RobertGawron/GeigerMullerCounter/Software/HardwareDataLogger/README.md

# HardwareDataLogger

 

## Summary

It's a simple hardware data logger, that presents data both on LCD and via COM port so it's possible to gather data using PC and do further analysis. Currently it supports only pulse counting.

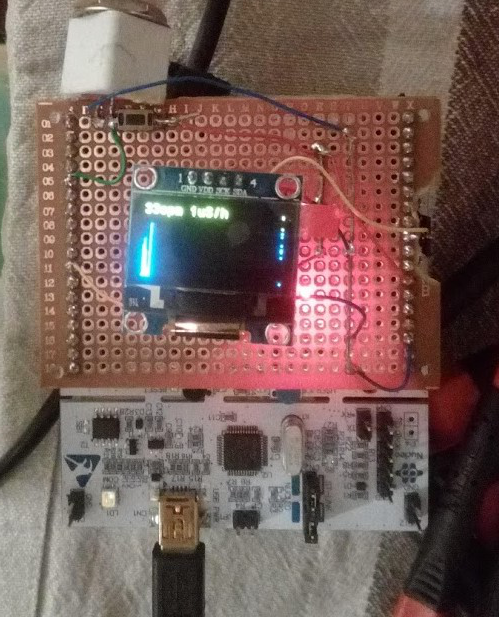
[picture p3: Software/HardwareDataLogger/Documentation/Pictures/Device_10_01_2019.jpg]
Device Picture


## Hardware

The device is based on NUCLEO-F091RC evaluation board with added custom-made shield.

TODO: hardware documentation of the shield.

## Software

Firmware were made using CubeMX, Eclipse is used for firmware development.

PC Simulation of Firmware was made using Python+Qt, it uses build .so variant of the firmware (Makefile is used for firmware variant generation).
