RobertGawron/GeigerMullerCounter/Hardware/GeigerMullerCounter/GeigerMullerCounter.kicad_pcb

## KiCad design Hardware/GeigerMullerCounter/GeigerMullerCounter.kicad_pcb (2024-09-13)

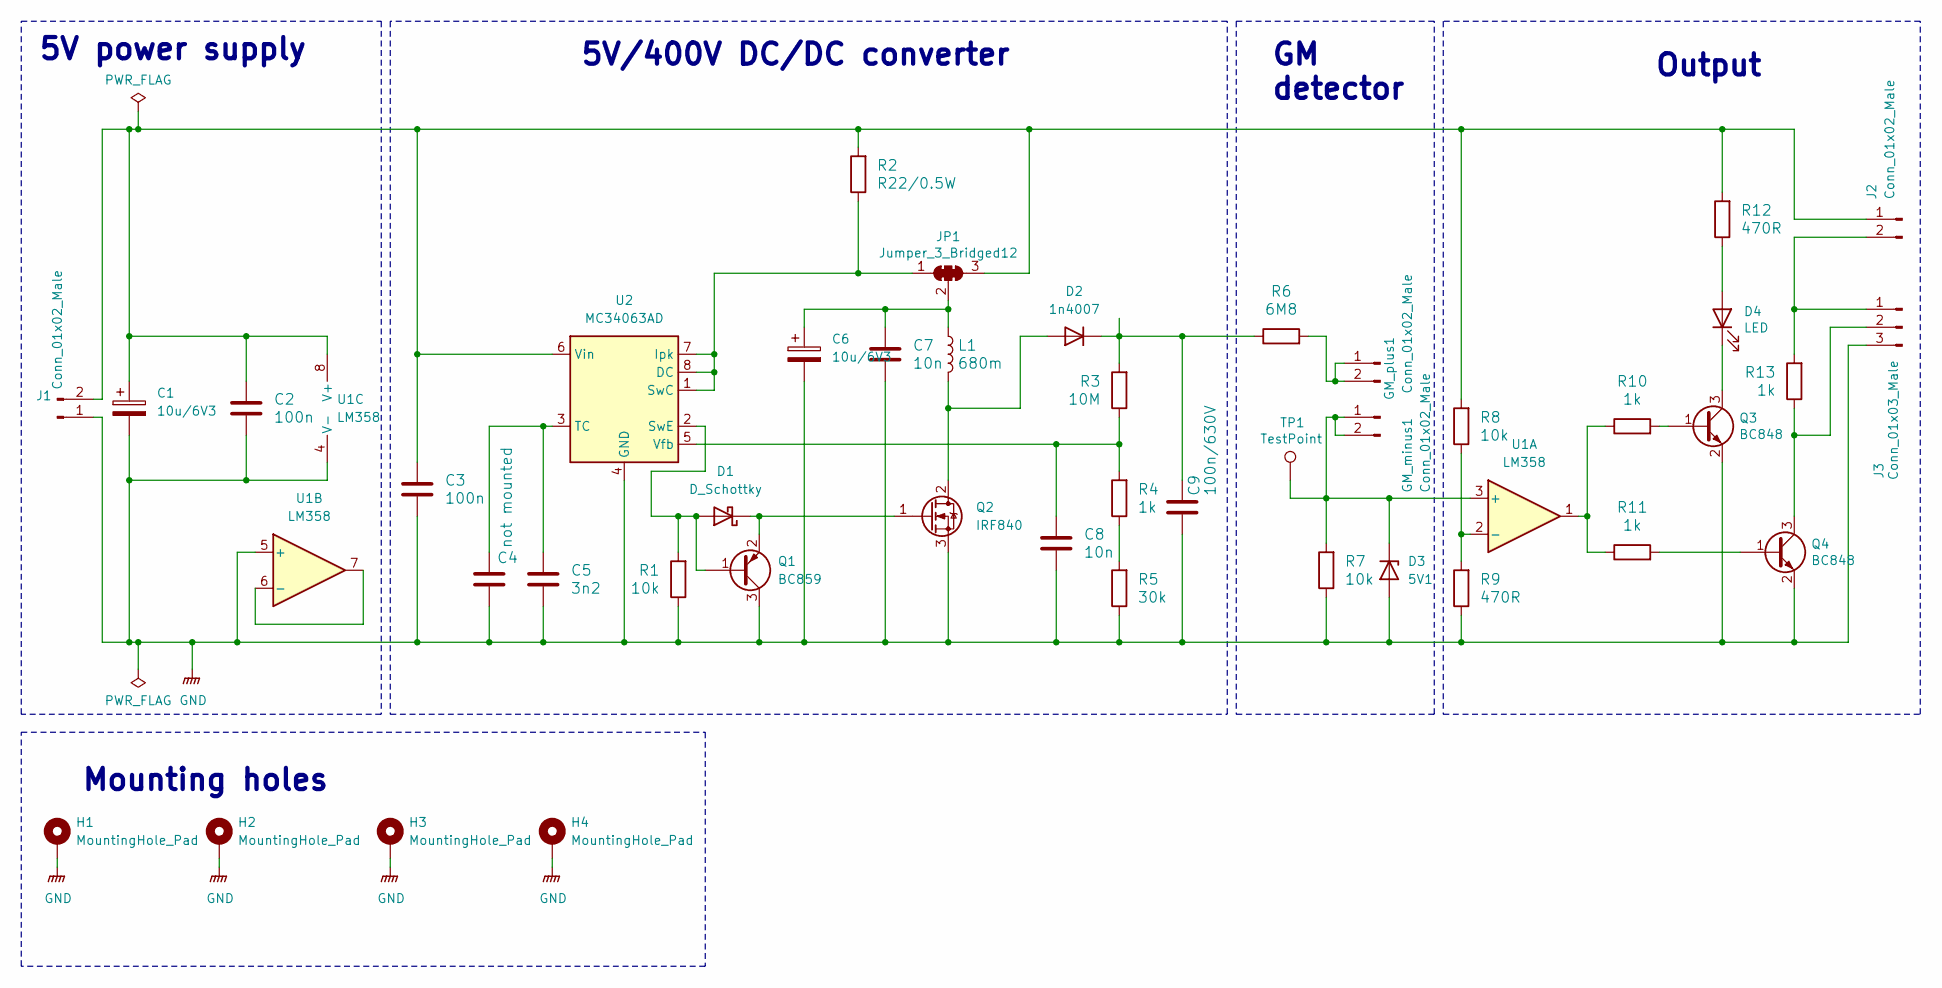
[picture p5: schematic GeigerMullerCounter.kicad_sch]

Parts:
C1, C6: 10u/6V3; CP_EIA-3528-21_Kemet-B
C2, C3: 100n; C_0805_2012Metric
C4: not mounted; C_0805_2012Metric
C5: 3n2; C_0805_2012Metric
C7, C8: 10n; C_0805_2012Metric
C9: 100n/630V; C_Rect_L13.5mm_W5.0mm_P10.00mm_FKS3_FKP3_MKS4
D1: D_Schottky; D_SOT-23_ANK
D2: 1n4007; D_DO-41_SOD81_P7.62mm_Horizontal
D3: 5V1; D_A-405_P2.54mm_Vertical_KathodeUp
D4: LED; LED_0805_2012Metric
GM_minus1: Conn_01x02_Male; Pin_Header_Straight_1x02_Pitch2.54mm
GM_plus1: Conn_01x02_Male; Pin_Header_Straight_1x02_Pitch2.54mm
H1, H2, H3, H4: MountingHole_Pad; MountingHole_3.5mm_Pad
J1, J2: Conn_01x02_Male; PinHeader_1x02_P2.54mm_Vertical
J3: Conn_01x03_Male; PinHeader_1x03_P2.54mm_Vertical
JP1: Jumper_3_Bridged12; SolderJumper-3_P1.3mm_Bridged12_Pad1.0x1.5mm
L1: 680m; L_Radial_D7.5mm_P5.00mm_Fastron_07P
Q1: BC859; TSOT-23
Q2: IRF840; TO-220-3_Vertical
Q3, Q4: BC848; SOT-23
R1, R8: 10k; R_0805_2012Metric
R2: R22/0.5W; R_Axial_DIN0207_L6.3mm_D2.5mm_P2.54mm_Vertical
R3: 10M; R_Axial_DIN0207_L6.3mm_D2.5mm_P5.08mm_Vertical
R4, R10, R11, R13: 1k; R_0805_2012Metric
R5: 30k; R_0805_2012Metric
R6: 6M8; R_Axial_DIN0207_L6.3mm_D2.5mm_P7.62mm_Horizontal
R7: 10k; R_0805_2012Metric_Pad1.15x1.40mm_HandSolder
R9, R12: 470R; R_0805_2012Metric
TP1: TestPoint; TestPoint_Pad_D1.5mm
U1: LM358; SO-8_5.3x6.2mm_P1.27mm
U2: MC34063AD; SO-8_5.3x6.2mm_P1.27mm

Connections:
GND: C1.2, C2.2, C3.2, C4.2, C5.2, C6.2, C7.2, C8.2, C9.2, D3.2 (A), H1.1, H2.1, H3.1, H4.1, J1.1, J3.3, Q1.3 (C), Q2.3 (S), Q3.2 (E), Q4.2 (E), R1.1, R5.1, R7.1, R9.1, U1.4 (V-), U1.5 (+), U2.4 (GND)
unnamed: D1.2 (A), Q1.1 (B), R1.2, U2.2 (SwE)
unnamed: D1.1 (K), Q1.2 (E), Q2.1 (G)
unnamed: D2.2 (A), L1.2, Q2.2 (D)
unnamed: C9.1, D2.1 (K), R3.2, R6.1
unnamed: D3.1 (K), GM_minus1.1, GM_minus1.2, R7.2, TP1.1, U1.3 (+)
unnamed: D4.2 (A), R12.1
unnamed: D4.1 (K), Q3.3 (C)
unnamed: GM_plus1.1, GM_plus1.2, R6.2
unnamed: C1.1, C2.1, C3.1, J1.2, J2.1, JP1.3 (B), R2.2, R8.2, R12.2, U1.8 (V+), U2.6 (Vin)
unnamed: J2.2, J3.1, R13.2
unnamed: J3.2, Q4.3 (C), R13.1
unnamed: JP1.1 (A), R2.1, U2.1 (SwC), U2.7 (Ipk), U2.8 (DC)
unnamed: C6.1, C7.1, JP1.2 (C), L1.1
unnamed: Q3.1 (B), R10.2
unnamed: Q4.1 (B), R11.2
unnamed: R4.1, R5.2
unnamed: R10.1, R11.1, U1.1
unnamed: R8.1, R9.2, U1.2 (-)
unnamed: U1.6 (-), U1.7
unnamed: C4.1, C5.1, U2.3 (TC)
unnamed: C8.1, R3.1, R4.2, U2.5 (Vfb)

Notes on the sheet:
Mounting holes
Output
5V/400V DC/DC converter
GM detector
5V power supply

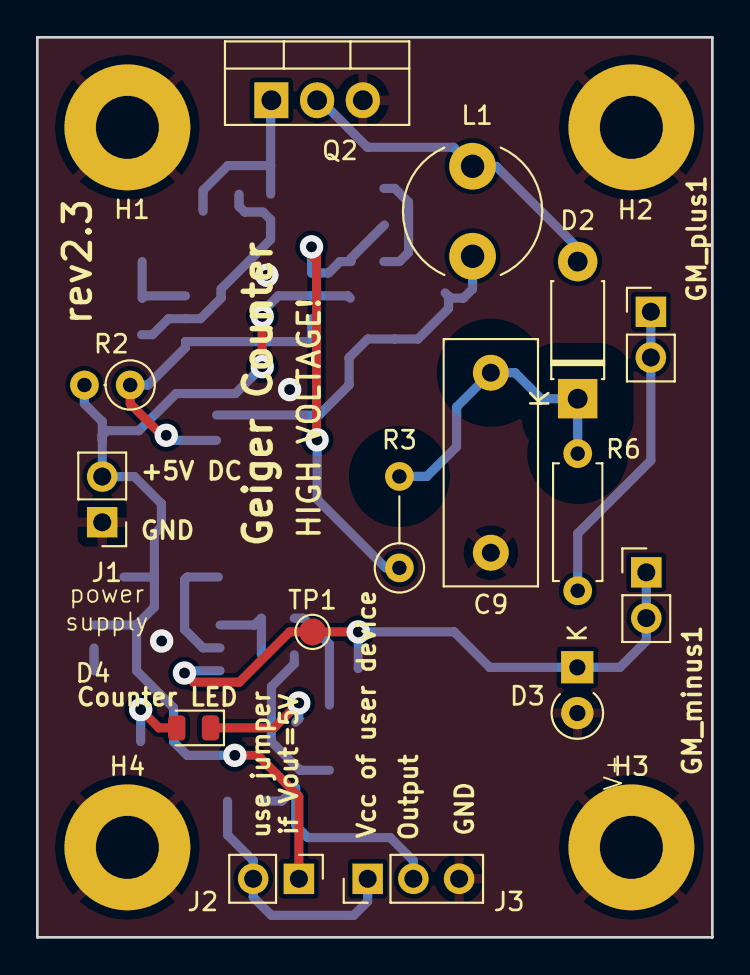
[picture p6: board GeigerMullerCounter.kicad_pcb from above]

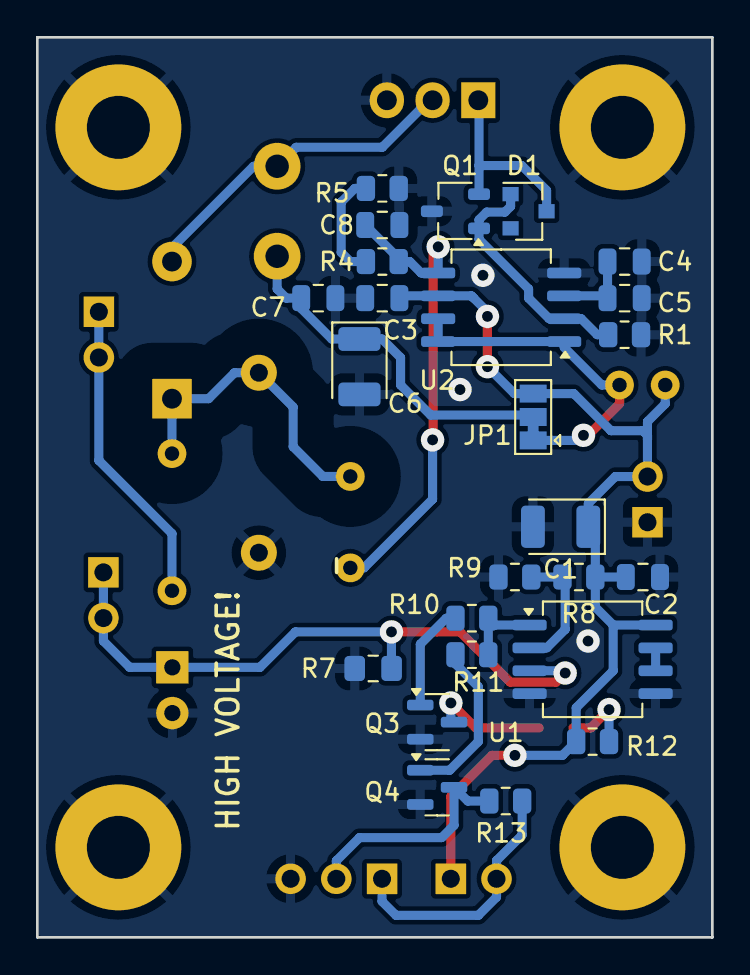
[picture p7: board GeigerMullerCounter.kicad_pcb from below]

Board: 2 copper layers, 37.5 x 50.0 mm, 44 parts (25 on the bottom side), 22 nets.
