RobertGawron/GeigerMullerCounter/(threads)

Thread 2 (2015-07-02):

Store data permanently.

RobertGawron, 2015-07-02:
Store data on the SD card or in EEPROM, provide way to download the data to the PC.

RobertGawron, 2019-08-11:
STM32 board and its firmware will be replaced by dedicated data acquisition module.

Closed 2019-08-11.

Thread 5 (2015-07-02):

Verify transistor type for driving the speaker.

RobertGawron, 2015-07-02:
What should be the max power of the transistor?

RobertGawron, 2018-09-15:
speaker no longer in use (but still is as an option on the pcb)

Closed 2018-09-15.

Thread 6 (2015-07-02):

HW filtering capacitor has incorrect package.

RobertGawron, 2015-07-02:
Fix according to capacitor type/package used.

Closed 2018-09-15.

Thread 7 (2015-07-02):

Add Bluetooth support.

RobertGawron, 2015-07-02:
Based on HC-05 board.

RobertGawron, 2019-08-11:
STM32 board and its firmware will be replaced by dedicated data acquisition module.

Closed 2019-08-11.

Thread 9 (2015-07-02):

Add unit tests.

RobertGawron, 2015-07-02:
Framework: Check
http://check.sourceforge.net/

RobertGawron, 2018-09-15:
Would be especially (or maybe only) useful for CircularBuffer.

RobertGawron, 2019-08-11:
STM32 board and its firmware will be replaced by dedicated data acquisition module.

Closed 2019-08-11.

Thread 10 (2015-07-03):

SD Card support

RobertGawron, 2015-07-03:
Lib: http://stm32f4-discovery.com/2014/07/library-21-read-sd-card-fatfs-stm32f4xx-devices/

RobertGawron, 2018-09-15:
Duplicates with #2

Closed 2018-09-15.

Thread 12 (2016-08-22):

Question

MatejKovacic, 2016-08-22:
Hi,

sorry to bother you here. I was looking for your contact on your website, but there is none.

Anyway, I found your project very interesting. In fact, I have one SBM-20 Geiger tube (I planned to build my own Geiger counter a few years ago, but never finished it). What is the difference between this and your STS-5 tube?

Also, where did you find metallic holders for lamps? Do you have a figure (picture of a prototype) of the circuit and list of required materials?

And the final question - did you plan to make a digital Geiger counter based on Raspberry Pi?

P. S. My e-mail can be found here: https://keyserver.ubuntu.com/pks/lookup?op=get&search=0xBEA5286DA9CF4A88

Regards,
M.

RobertGawron, 2017-01-06:
One can be replaced by other, they are pretty much the same.

Holders are just regular fuses holders, Russians were smart and mechanically designed theirs tubes to be able to place them in holders popular in civil equipment - stocks of popular parts are easier to find in case of e.g. war.

Circuit is presented here: https://robertgawron.blogspot.com/2015/02/homemade-geigermuller-counter-part-i.html

I don't plan at the moment, but there is version for Aurduino:
https://robertgawron.blogspot.com/2016/07/using-arduino-to-process-data-from_24.html

TBH its histograms works quite awful, but rest of it is ok.

Regards,
Bob

Closed 2018-09-15.

Thread 56 (2019-09-30):

geiger with stm32

123LY321, 2019-09-30:
Sorry to bother you, but I want to make a geiger detection suite for the main chip using stm32. Can I get a circuit diagram from you? Thank you

RobertGawron, 2019-09-30:
Hi,

you need a diagram of the gieger counter or diagram how to connect it and LCD to STM32 eval board?

If the first one, you can open the project files in hardware directory using KiCAD and you will have the diagram.

-Robert

Closed 2020-10-08.

Thread 89 (2020-10-16):

Zener diode details

piotrkochan, 2020-10-16:
Please provide what zener diode should be used

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

RobertGawron, 2020-10-16:
Hello this diode is to protect input of op-amp if  voltage spike from GM tube would be for some reason too big and it's just in case.

Something around op-amp's power supply value would be good, so 5V.

Closed 2020-10-17.
