RobertGawron/GeigerMullerCounter/(commit log)

2019-06-16 sw from my old arduino project as a draft
2019-06-16 working arduino sw firmware
2019-06-16 pcb for gm counter, gm tube connector and arduino
    [GeigerMuller_shield.brd, GeigerMuller_shield.sch, main.brd, main.sch, tube-connector.brd, tube-connector.sch]
2019-06-16 moved from eagle to kicad
    [GeigerMuller_shield.brd, GeigerMuller_shield.sch, main.brd, main.kicad_pcb, main.sch, tube-connector.brd, tube-connector.sch]
2019-06-16 stm32 fimware
    [GeigerCounterFirmware Run.cfg]
2019-08-11 unified with my other repositories
    [GeigerCounterFirmware Run.cfg, main.kicad_pcb, main.sch]
2020-10-09 draft + working timer
    [NUCLEO-F091RC Debug.cfg]
2020-10-09 add missing component initialization
    [main.c]
2020-10-09 remove project for older board version
    [GeigerCounterFirmware Run.cfg]
2020-10-10 fixed logger timer to 60s
    [main.c]
2020-10-15 remove files moved to new repo
    [NUCLEO-F091RC Debug.cfg]
2020-10-15 Squashed 'Software/Firmware/' content from commit 37d90c36
    git-subtree-dir: Software/Firmware
    git-subtree-split: 37d90c36ef6dff2428dff3a75682a6a990aea3fe
    [NUCLEO-F091RC Debug.cfg]
2020-10-15 cleanup after moving firmware to separate repo
    [NUCLEO-F091RC Debug.cfg]
2020-10-17 remove old version
    [NUCLEO-F091RC Debug.cfg]
2020-10-17 Squashed 'Software/HardwareDataLogger/' content from commit 36e64a0b
    git-subtree-dir: Software/HardwareDataLogger
    git-subtree-split: 36e64a0b74689bc3145da8180f2f13aac98a8adf
    [NUCLEO-F091RC Debug.cfg]
2020-10-23 move from travis to github actions, move ,gitignore for Kicad files into hardware directory
2020-10-24 Squashed 'Software/HardwareDataLogger/' changes from 36e64a0b..dc3c36eb
    dc3c36eb Merge pull request #21 from RobertGawron/develop
    a8342c6a Merge pull request #20 from RobertGawron/feature/add_contionous_integration
    304d8cda fix c linter issues
    4a7e1a6d Merge pull request #19 from RobertGawron/develop
    1880f227 Merge pull request #18 from RobertGawron/feature/add_contionous_integration
    7c2c33d9 exclude external libs from repo programming language statistics
    8b80624f Merge pull request #17 from RobertGawron/develop
    e224b3cc Merge pull request #16 from RobertGawron/feature/add_contionous_integration
    b6c5e9e7 fixed formatting
    d7cbf0f7 add static code analysis build for ci (c files)
    a741c742 add s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
    [main.c]
2020-11-06 Add info about zener diode voltage (#89)
    [main.sch]
2024-09-13 hw revision 2.3
    [GeigerMullerCounter.kicad_pcb, GeigerMullerCounter.kicad_sch, main.kicad_pcb, main.sch]
